seanboe/QuadrupedProject/images/V1-1Rendering.png

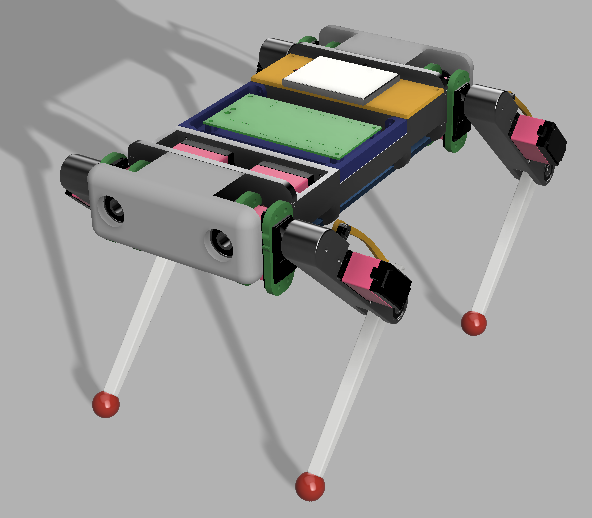
images/V1-1Rendering.png
