seanboe/QuadrupedProject/images/V1-1Side.png

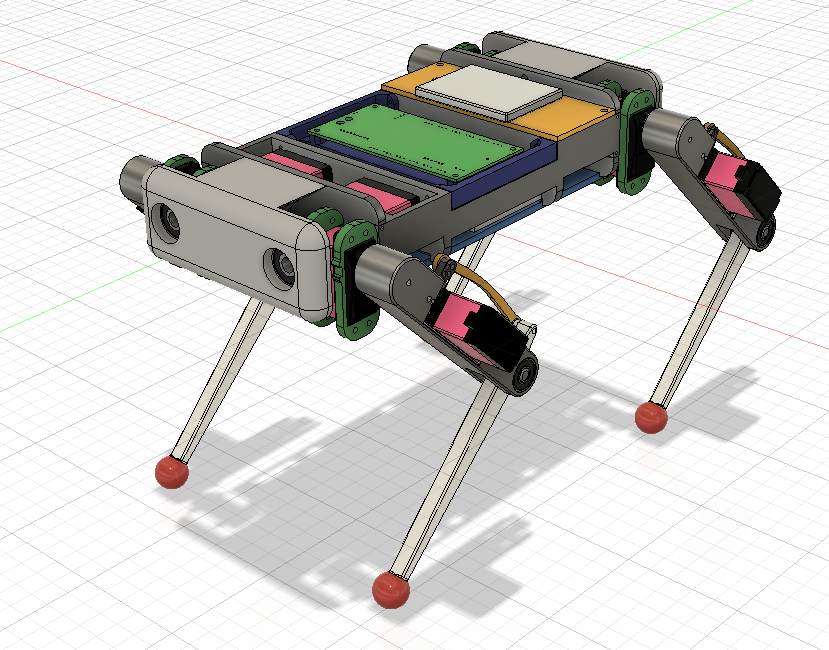
images/V1-1Side.png
