seanboe/QuadrupedProject/images/V1Front.png

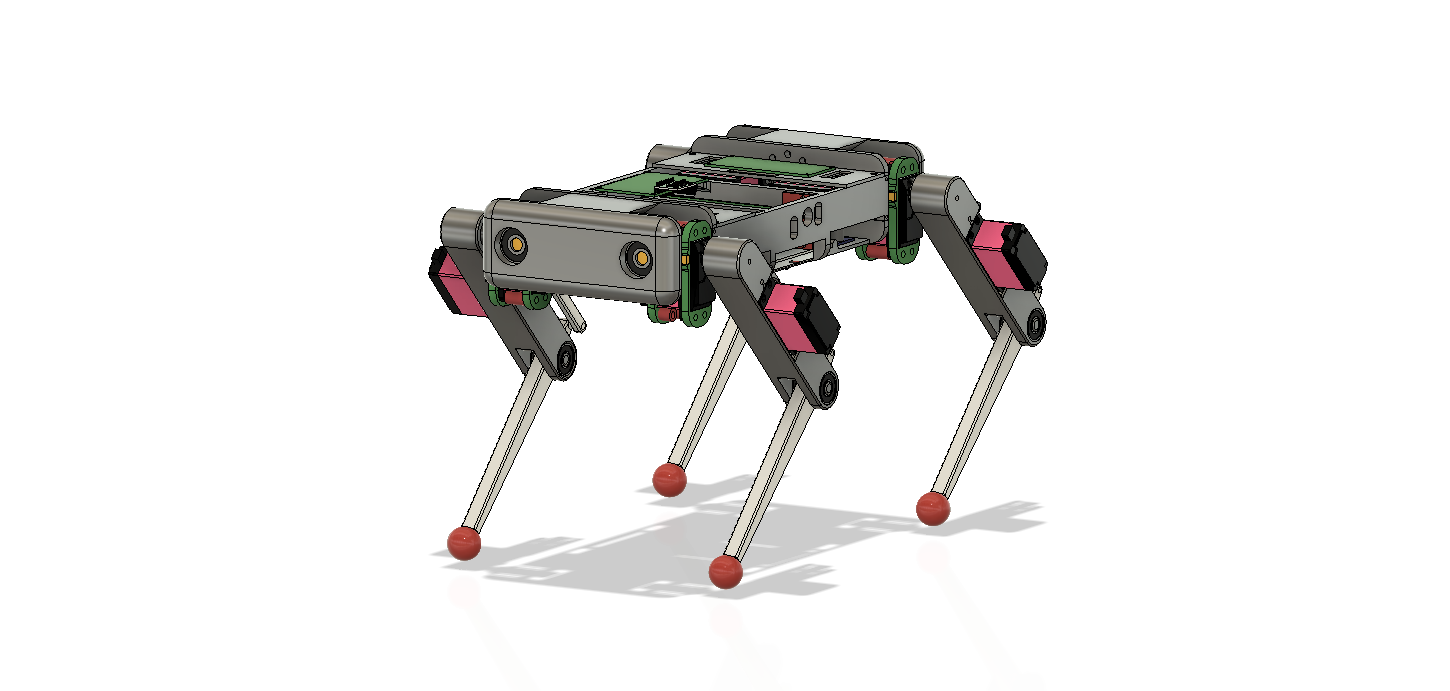
images/V1Front.png
