seanboe/QuadrupedProject/images/V1TopBack.png

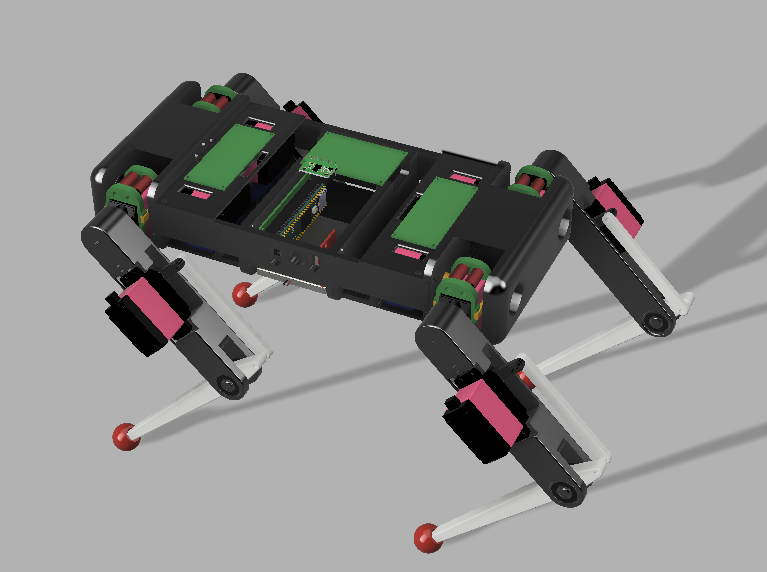
images/V1TopBack.png
