seanboe/QuadrupedProject/(threads)

Thread 1 (2021-05-17):

Better Documentation

seanboe, 2021-05-17:
Better documentation is coming. I'm organizing a BOM for the robot and PCBs, and a shared fusion360 project link will be live shortly.

seanboe, 2021-05-17:
Also, README.md in `Hardware` is old...

seanboe, 2021-06-13:
Readme updated

seanboe, 2021-06-13:
Added BOM for the robot but not the PCB (this will be added once I have a pcb that I'm happy with).
