seanboe/QuadrupedProject/Code/Teensy41Main/src/motorSetup.cpp

// Holds all the stuff specifically for the motors
// Define each motor's characteristicts here! Each motor has a struct object.
// The struct itself is defined in Kinematics.h to keep everything consistent. 
// Here is the definition for reference:
// typedef struct {
//   uint8_t controlPin;

//   // Angle/calculation stuff
//   int16_t angleDegrees;
//   int16_t previousDegrees;     // previous degrees since last call to updateDynamicPositions()
//   int16_t dynamicDegrees;

//   // Calibration
//   uint16_t calibOffset;         // This is an offset for calibration (to keep the motor accurate)
//   uint8_t maxPos;
//   uint8_t minPos;
//   uint16_t applicationOffset;   // This is an offset for putting the calculated angles in contex.
//                                 // It is likely that the zero positions of the motors isn't where
//                                 // calculations assumes it to be, so you need an offset to make 
//                                 // sure that the angle is correct relative to the motor's zero.
// } Motor;

#include <Arduino.h>

// The struct and various enums are defined inside here
#include <Kinematics.h>

#include <motorSetup.h>

// Called in setup
void initMotorVals(Motor _motors[]) {

  _motors[0] = L1M1;
  _motors[1] = L1M2;
  _motors[2] = L1M3;
  _motors[3] = L2M1;
  _motors[4] = L2M2;
  _motors[5] = L2M3;
  _motors[6] = L3M1;
  _motors[7] = L3M2;
  _motors[8] = L3M3;
  _motors[9] = L4M1;
  _motors[10] = L4M2;
  _motors[11] = L4M3;

  // ********************** LEG 1 **********************
  _motors[indexOfMotor(LEG_1, M1)].controlPin = 14;
  _motors[indexOfMotor(LEG_1, M1)].calibOffset = 0;
  _motors[indexOfMotor(LEG_1, M1)].maxPos = 135;
  _motors[indexOfMotor(LEG_1, M1)].minPos = 30;
  _motors[indexOfMotor(LEG_1, M1)].applicationOffset = 90;

  _motors[indexOfMotor(LEG_1, M2)].controlPin = 37;
  _motors[indexOfMotor(LEG_1, M2)].calibOffset = 80;
  _motors[indexOfMotor(LEG_1, M2)].maxPos = 270;
  _motors[indexOfMotor(LEG_1, M2)].minPos = 0;
  _motors[indexOfMotor(LEG_1, M2)].applicationOffset = 0;

  _motors[indexOfMotor(LEG_1, M3)].controlPin = 36;
  _motors[indexOfMotor(LEG_1, M3)].calibOffset = 10;
  _motors[indexOfMotor(LEG_1, M3)].maxPos = 130;
  _motors[indexOfMotor(LEG_1, M3)].minPos = 45;
  _motors[indexOfMotor(LEG_1, M3)].applicationOffset = 0;

  // ********************** LEG 2 **********************
  _motors[indexOfMotor(LEG_2, M1)].controlPin = 23;
  _motors[indexOfMotor(LEG_2, M1)].calibOffset = 60;
  _motors[indexOfMotor(LEG_2, M1)].maxPos = 120;
  _motors[indexOfMotor(LEG_2, M1)].minPos = 45;
  _motors[indexOfMotor(LEG_2, M1)].applicationOffset = 90;

  _motors[indexOfMotor(LEG_2, M2)].controlPin = 22;
  _motors[indexOfMotor(LEG_2, M2)].calibOffset = 120;
  _motors[indexOfMotor(LEG_2, M2)].maxPos = 270;
  _motors[indexOfMotor(LEG_2, M2)].minPos = 0;
  _motors[indexOfMotor(LEG_2, M2)].applicationOffset = 90;

  _motors[indexOfMotor(LEG_2, M3)].controlPin = 15;
  _motors[indexOfMotor(LEG_2, M3)].calibOffset = 55;
  _motors[indexOfMotor(LEG_2, M3)].maxPos = 130;
  _motors[indexOfMotor(LEG_2, M3)].minPos = 45;
  _motors[indexOfMotor(LEG_2, M3)].applicationOffset = 90;

  // ********************** LEG 3 **********************
  _motors[indexOfMotor(LEG_3, M1)].controlPin = 0;
  _motors[indexOfMotor(LEG_3, M1)].calibOffset = 35;
  _motors[indexOfMotor(LEG_3, M1)].maxPos = 135;
  _motors[indexOfMotor(LEG_3, M1)].minPos = 30;
  _motors[indexOfMotor(LEG_3, M1)].applicationOffset = 90;

  _motors[indexOfMotor(LEG_3, M2)].controlPin = 1;
  _motors[indexOfMotor(LEG_3, M2)].calibOffset = 45;
  _motors[indexOfMotor(LEG_3, M2)].maxPos = 270;
  _motors[indexOfMotor(LEG_3, M2)].minPos = 0;
  _motors[indexOfMotor(LEG_3, M2)].applicationOffset = 90;

  _motors[indexOfMotor(LEG_3, M3)].controlPin = 2;
  _motors[indexOfMotor(LEG_3, M3)].calibOffset = 0;
  _motors[indexOfMotor(LEG_3, M3)].maxPos = 130;
  _motors[indexOfMotor(LEG_3, M3)].minPos = 45;
  _motors[indexOfMotor(LEG_3, M3)].applicationOffset = 90;

  // ********************** LEG 4 **********************
  _motors[indexOfMotor(LEG_4, M1)].controlPin = 3;
  _motors[indexOfMotor(LEG_4, M1)].calibOffset = 80;
  _motors[indexOfMotor(LEG_4, M1)].maxPos = 120;
  _motors[indexOfMotor(LEG_4, M1)].minPos = 45;
  _motors[indexOfMotor(LEG_4, M1)].applicationOffset = 90;

  _motors[indexOfMotor(LEG_4, M2)].controlPin = 4;
  _motors[indexOfMotor(LEG_4, M2)].calibOffset = 70;
  _motors[indexOfMotor(LEG_4, M2)].maxPos = 270;
  _motors[indexOfMotor(LEG_4, M2)].minPos = 0;
  _motors[indexOfMotor(LEG_4, M2)].applicationOffset = 0;

  _motors[indexOfMotor(LEG_4, M3)].controlPin = 5;
  _motors[indexOfMotor(LEG_4, M3)].calibOffset = 70;
  _motors[indexOfMotor(LEG_4, M3)].maxPos = 130;
  _motors[indexOfMotor(LEG_4, M3)].minPos = 45;
  _motors[indexOfMotor(LEG_4, M3)].applicationOffset = 0;
}



uint16_t indexOfMotor(LegID leg, MotorID motor) {
  return ((leg - 1) * MOTORS_PER_LEG + motor) - 1;
}

int16_t constrainAngle(Motor _motors[], LegID legID, MotorID motorID, int16_t demandAngle) {
  if (demandAngle > _motors[indexOfMotor(legID, motorID)].maxPos)
    return _motors[indexOfMotor(legID, motorID)].maxPos;
  else if (demandAngle < _motors[indexOfMotor(legID, motorID)].minPos)
    return _motors[indexOfMotor(legID, motorID)].minPos;
  return demandAngle;
}

// This applies the offsets for the motors based on CONTEXT.
// The library calculates the angles for the all the JOINTS, 
// which isn't actually the angle each motor must achieve 
// since the 0 position of the motors is different for some.
// This is because they all have a defined zero-degrees 
// position and can turn 270 degrees but the motors must be 
// mirrored to each other on each side of the bot.

int16_t applyContextualOffset(Motor _motors[], LegID legID, MotorID motorID, int16_t demandAngle) {
  ContexType contexType = M1_standard;
  // int16_t demandAngle = _motors[indexOfMotor(legID, motorID)].angleDegrees;
  int16_t angle = demandAngle;

  switch (legID) {

    case LEG_1:
      switch (motorID) {
        case M1: contexType = M1_mirrored; break;
        case M2: contexType = M2_mirrored; break;
        case M3: contexType = M3_mirrored; break;
      } break;
    case LEG_2:
      switch (motorID) {
        case M1: contexType = M1_standard; break;
        case M2: contexType = M2_standard; break;
        case M3: contexType = M3_standard; break;
      } break;
    case LEG_3:
      switch (motorID) {
        case M1: contexType = M1_mirrored; break;
        case M2: contexType = M2_standard; break;
        case M3: contexType = M3_standard; break;
      } break;
    case LEG_4:
      switch (motorID) {
        case M1: contexType = M1_standard; break;
        case M2: contexType = M2_mirrored; break;
        case M3: contexType = M3_mirrored; break;
      } break;

  }

  switch (contexType) {

    case M1_standard: angle =  _motors[indexOfMotor(legID, motorID)].applicationOffset + angle; break;
    case M1_mirrored: angle =  _motors[indexOfMotor(legID, motorID)].applicationOffset - angle; break;

    case M2_standard: angle =  _motors[indexOfMotor(legID, motorID)].applicationOffset + angle; break;
    case M2_mirrored: angle =  90 - demandAngle; break;

    case M3_standard: angle = (2 * _motors[indexOfMotor(legID, motorID)].applicationOffset) - angle; break;
    case M3_mirrored: angle =  angle; break;
  }

  angle = constrainAngle(_motors, legID, motorID, angle);
  return angle;
};


uint16_t degreesToMicros(uint8_t inputDegrees, uint8_t calibOffset) {
  int microsecondsInput = ((DEGREES_TO_MICROS * inputDegrees) + 500 + calibOffset);    // 500 is a "magic number" of micros for the motors; before that they do nothing
  return microsecondsInput;
};


// All-in-one function
int16_t getPreparedAngles(Motor _motors[], LegID legID, MotorID motorID, unitType angleUnitType, ActivityType activityType) {

  int16_t angle = 0;

  // The prepared angle in contex
  if (activityType == DYNAMIC)
    angle = applyContextualOffset(_motors, legID, motorID, _motors[indexOfMotor(legID, motorID)].dynamicDegrees);
  else if (activityType == STATIC)
    angle = applyContextualOffset(_motors, legID, motorID, _motors[indexOfMotor(legID, motorID)].angleDegrees);

  if (angleUnitType == MILLIS) {
    return degreesToMicros(angle, motors[indexOfMotor(legID, motorID)].calibOffset);
  }
  return angle;
}
