seanboe/QuadrupedProject/(commit log)

2021-01-04 Added CoprocessorTalk and updated TeensyLC program
    added CoprocessorTalk library and updated the TeensyLC program to take input from the master. Will add support for transmission in the library soon.
2021-01-13 added voltage reading and display
    Battery voltage can be calculated from read stepped-down battery voltage. Max is 10 volts, with a 2:1 ratio of 10k resistors (teensy is a 3.3 volt board). Seems to display voltage accurately with roughly +- 0.2 V precision.
2021-01-18 Added first version of kinematics library
    first version of kinematics library with vertical translation active and working
2021-03-10 added config file
    added config file for constants and changed main code to replace controller
    [main.cpp]
2021-03-13 added interpolation beta
    interpolation added with correct (optimized timing for full motor movement
    [main.cpp]
2021-04-04 Added x-axis foot movement and rudimentary walking gaits
2021-04-13 y axis working (beta)
    y-axis seems to be working well
2021-05-17 Cleanup
    There are a lot of files I'm not using anymore (namely CoprocessorTalk, and the TeensyLC isn't being used anymore).
2021-05-17 updates
    Added the kinematics library (refer to my QuadrupedKinematics repo for all that)
2021-05-17 Updated PCB files
2021-06-01 Support for kinematics updates
2021-06-05 Added BOM
2021-06-11 relay support
2021-06-12 Initial commit NOT WORKING
    [main.cpp, motorSetup.cpp, motorSetup.h]
2021-06-12 stable for leg 2
2021-06-12 Added all motors
